dimulec/Watch-Winder/pictures/Watch_Winder_Disassembled_2.jpg

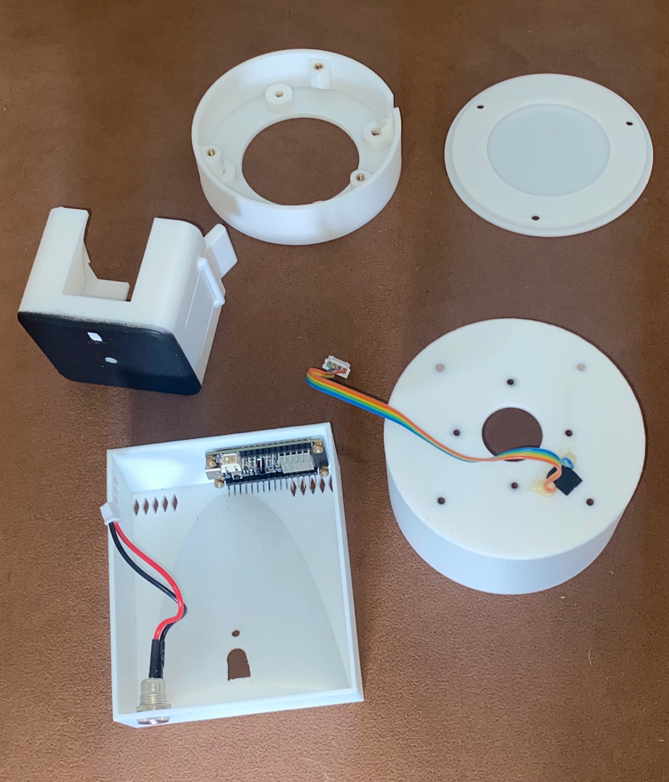
pictures/Watch_Winder_Disassembled_2.jpg
