dimulec/Watch-Winder/pictures/Watch_Winder_Disassembled_1.jpg

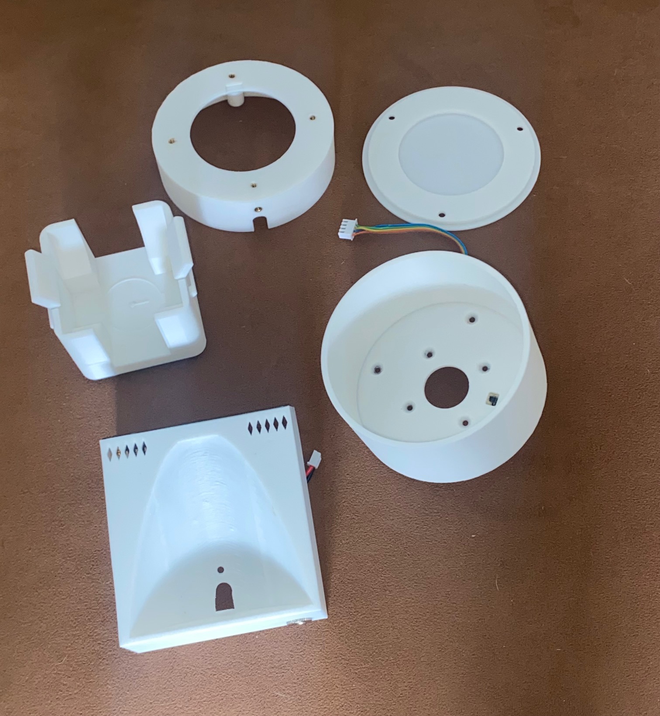
pictures/Watch_Winder_Disassembled_1.jpg
