dimulec/Watch-Winder/code/images/Both.bmp

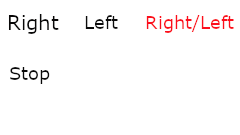
code/images/Both.bmp
