dimulec/Watch-Winder/pictures/2_Cross_Boards.jpg

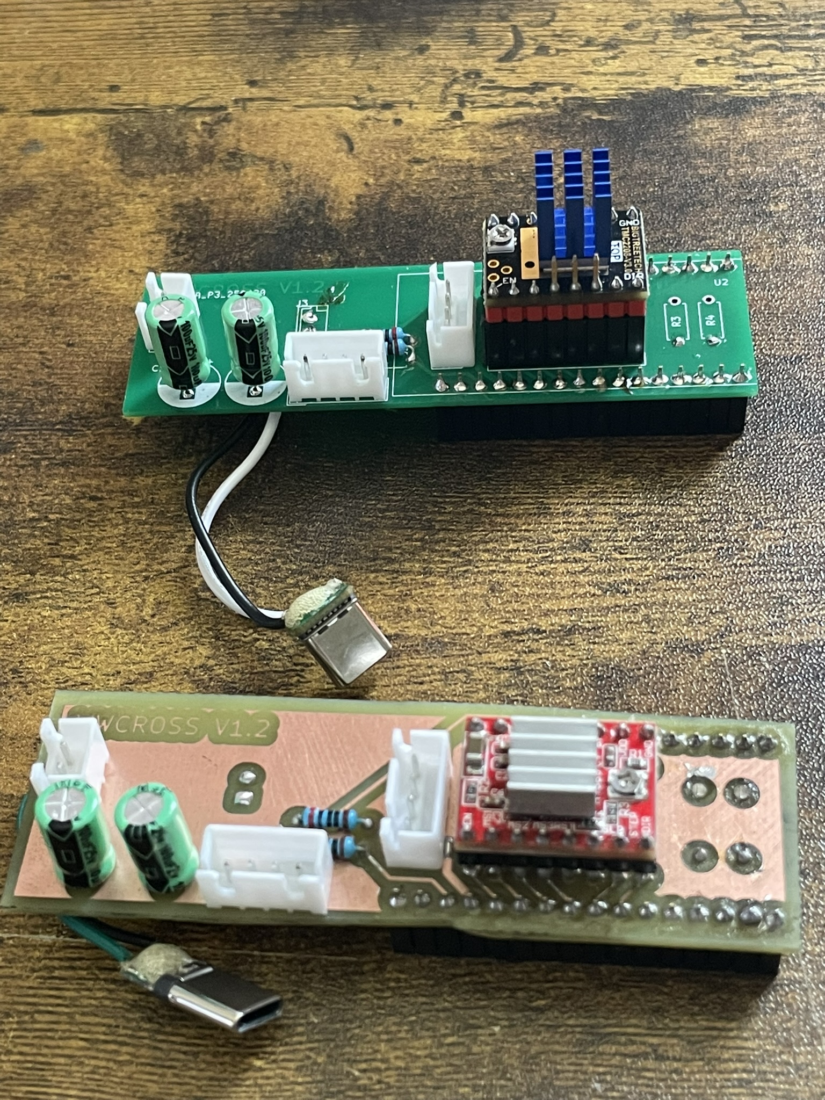
pictures/2_Cross_Boards.jpg
