dimulec/Watch-Winder/pictures/A_Bunch_of_Sensor_Boards.jpg

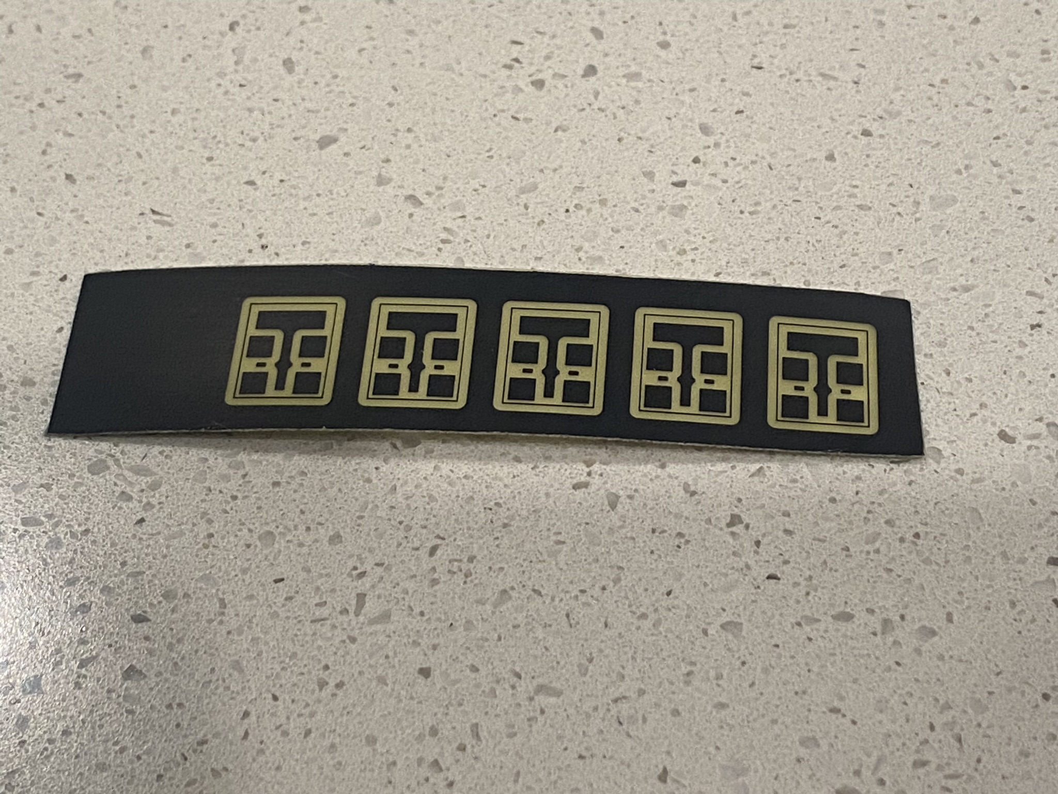
pictures/A_Bunch_of_Sensor_Boards.jpg
