dimulec/Watch-Winder/pictures/Back_View.jpg

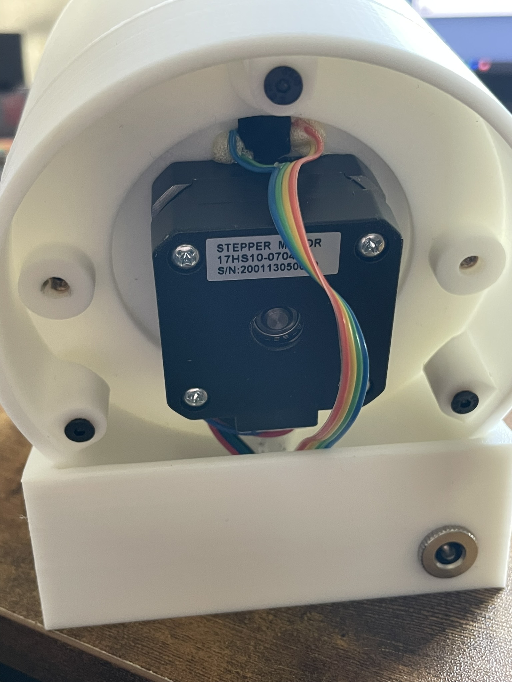
pictures/Back_View.jpg
