dimulec/Watch-Winder/pictures/Bottom_View.jpg

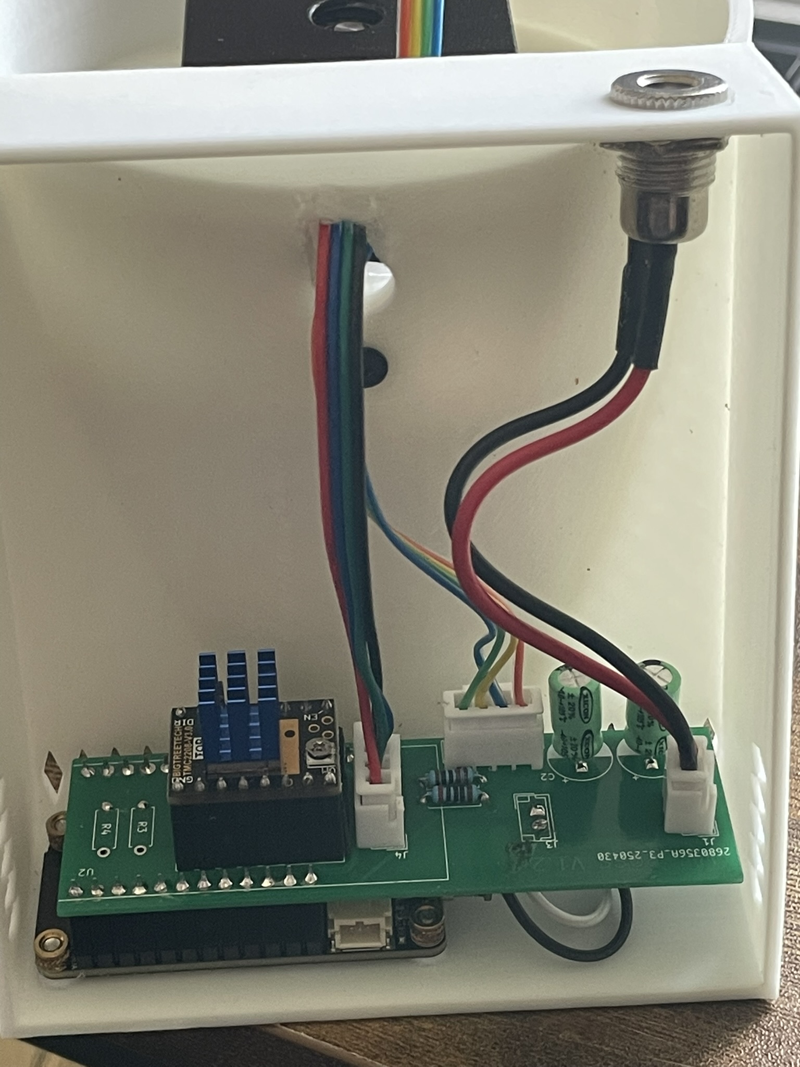
pictures/Bottom_View.jpg
