dimulec/Watch-Winder/pictures/Etching_H2O2+HCL.jpg

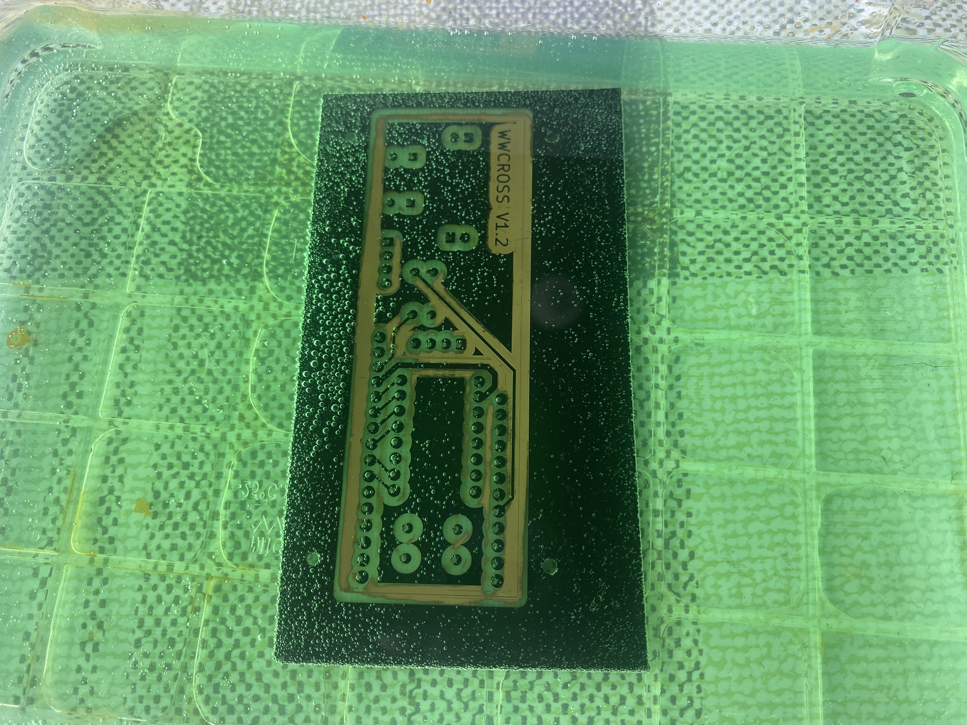
pictures/Etching_H2O2+HCL.jpg
