dimulec/Watch-Winder/pictures/Homemade_Cross_Board.jpg

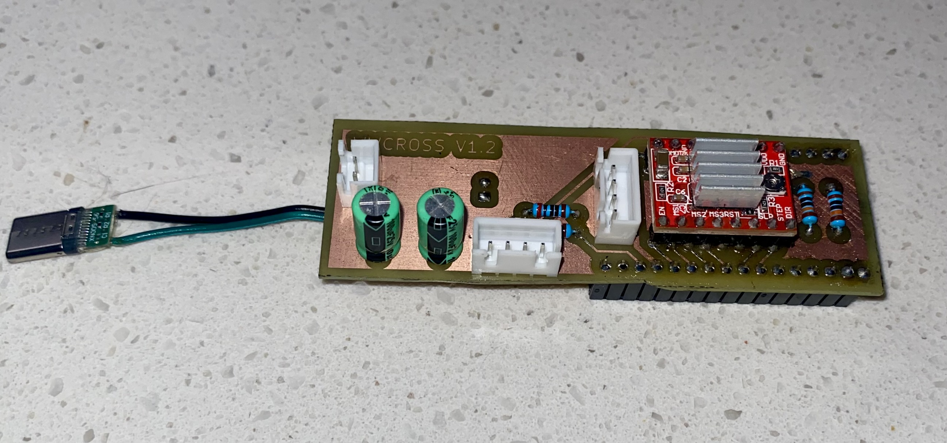
pictures/Homemade_Cross_Board.jpg
