dimulec/Watch-Winder/pictures/Homemade_Cross_Board_2.jpg

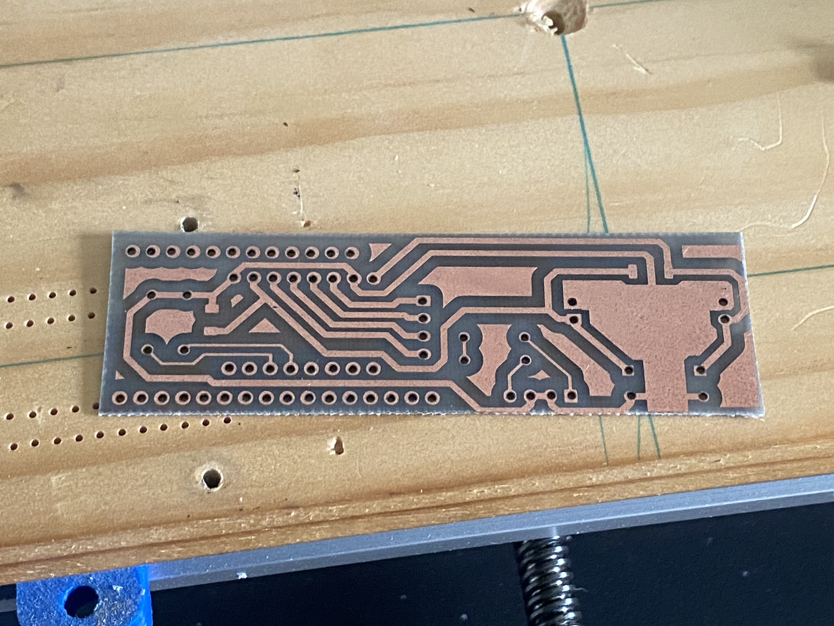
pictures/Homemade_Cross_Board_2.jpg
