dimulec/Watch-Winder/pictures/Ready_for_etching.jpg

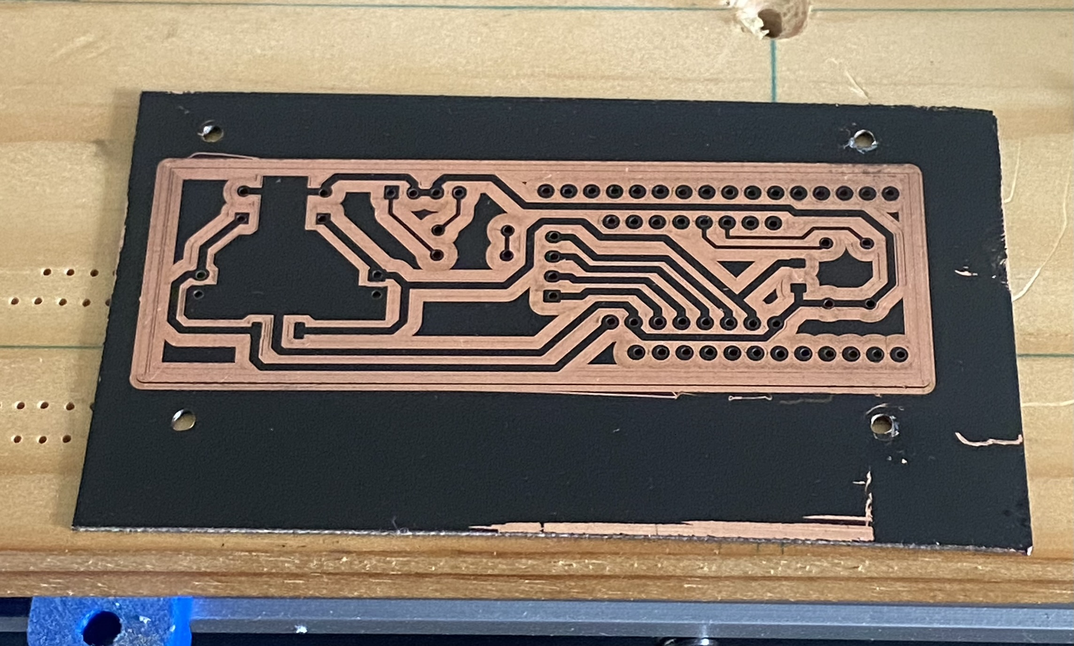
pictures/Ready_for_etching.jpg
