dimulec/Watch-Winder/pictures/Ready_for_Laser_Routing.jpg

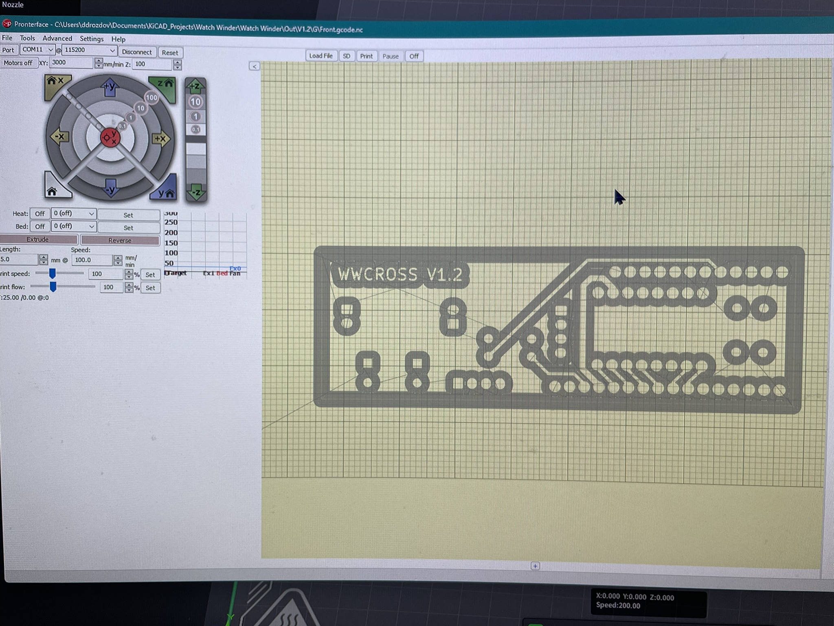
pictures/Ready_for_Laser_Routing.jpg
