dimulec/Watch-Winder/pictures/Rendering.png

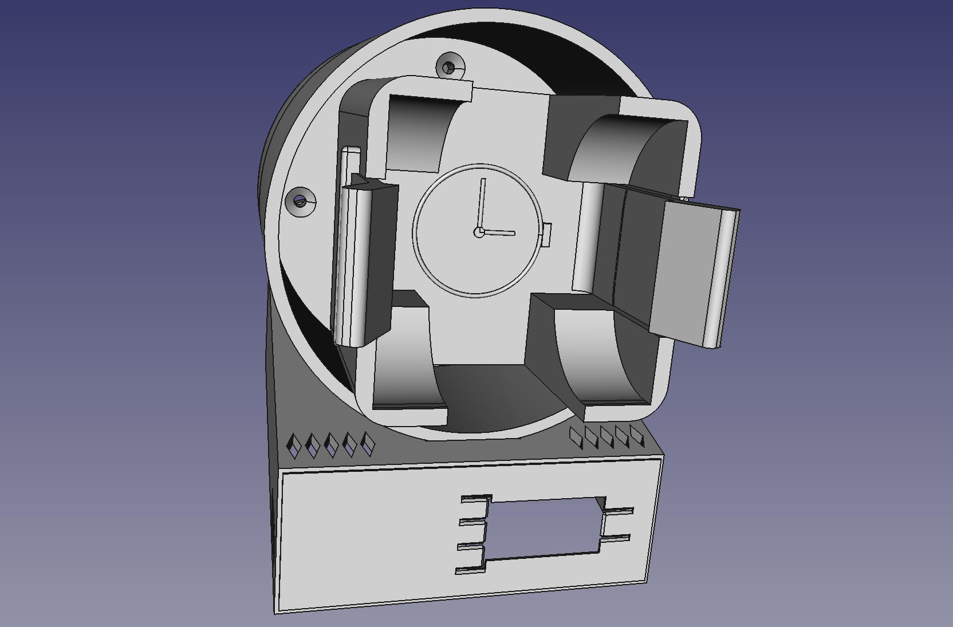
pictures/Rendering.png
