dimulec/Watch-Winder/pictures/Sensor_Layout.jpg

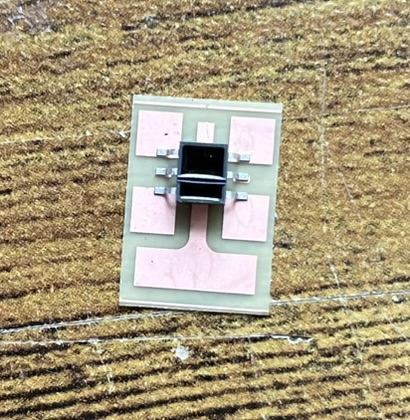
pictures/Sensor_Layout.jpg
