dimulec/Watch-Winder/pictures/Watch_Winder_PLA.jpg

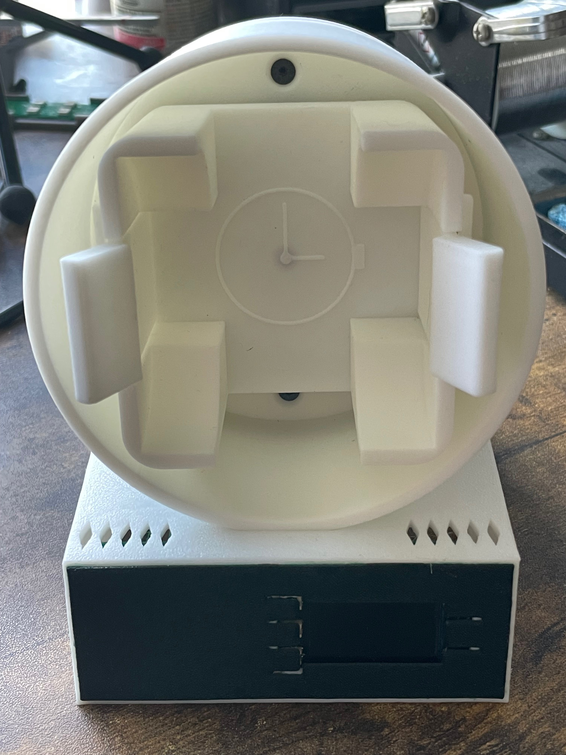
pictures/Watch_Winder_PLA.jpg
