dimulec/Watch-Winder/parts/Watch Holder 1.jpg

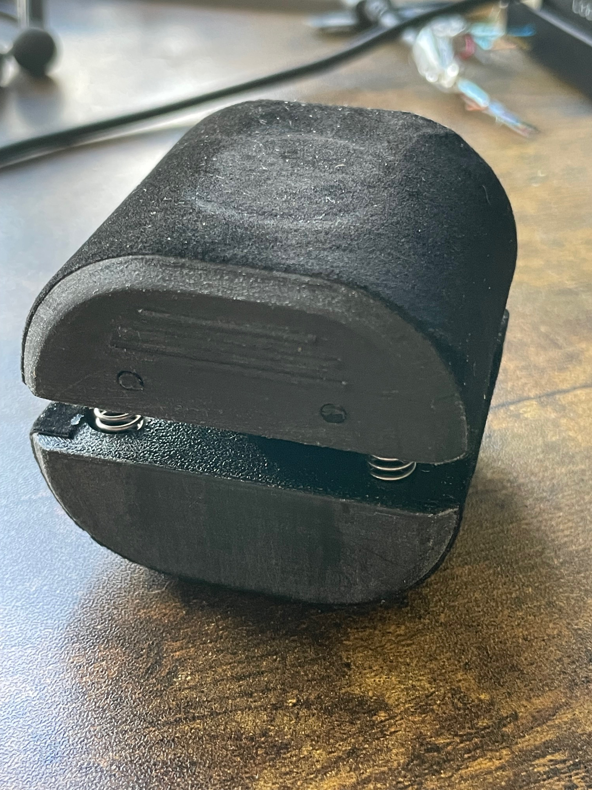
parts/Watch Holder 1.jpg
