dimulec/Watch-Winder/parts/Watch Holder 2.jpg

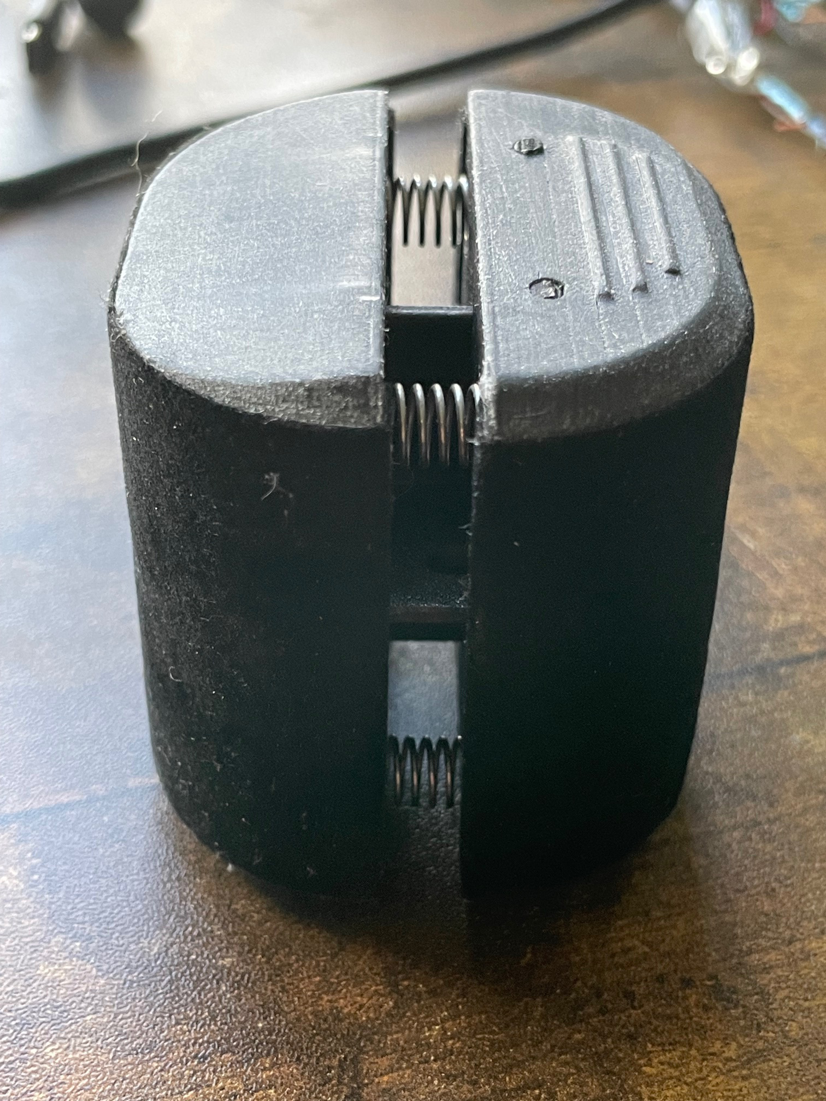
parts/Watch Holder 2.jpg
