dimulec/Watch-Winder/parts/Watch Winder-Guide 1.stl

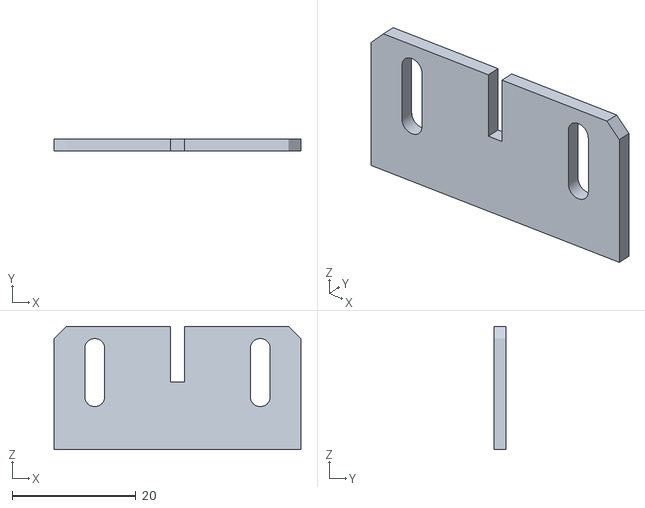
[picture p18: CAD file, 2025-05-09]
parts/Watch Winder-Guide 1.stl
40.0 x 2.00 x 20.0
