dimulec/Watch-Winder/parts/Watch Winder-Watch Holder Bottom V2.stl

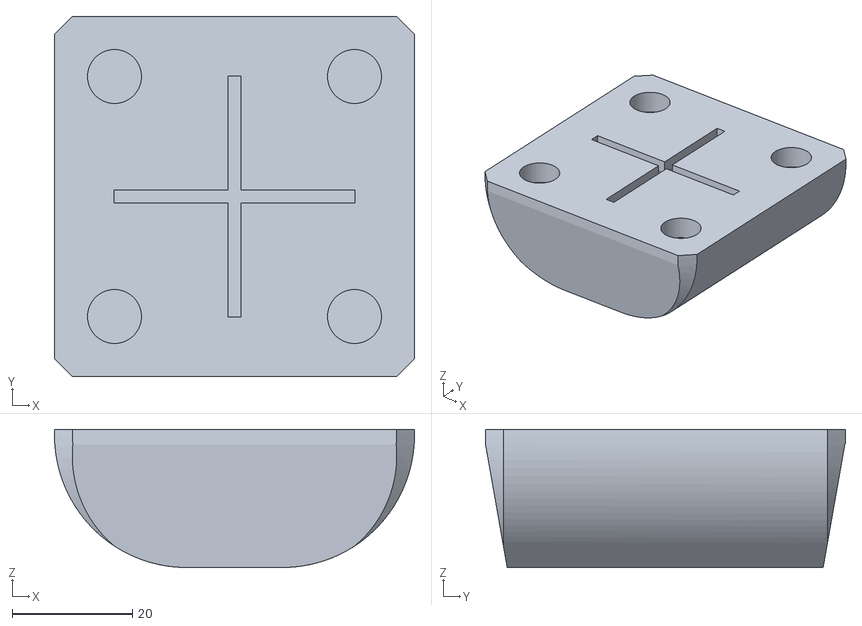
[picture p19: CAD file, 2025-05-09]
parts/Watch Winder-Watch Holder Bottom V2.stl
60.0 x 60.0 x 23.0
