dimulec/Watch-Winder/parts/Watch Winder-Watch Holder Top V2.stl

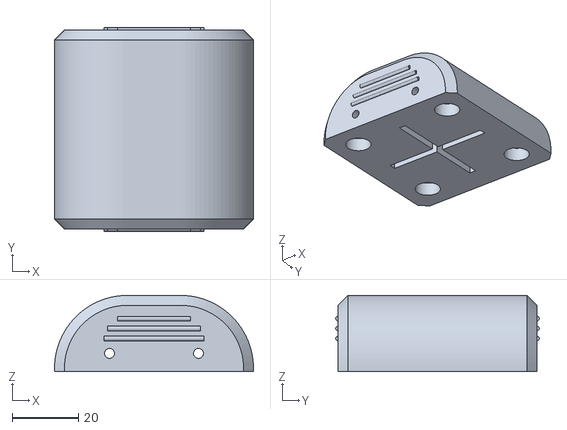
[picture p20: CAD file, 2025-05-09]
parts/Watch Winder-Watch Holder Top V2.stl
60.0 x 61.4 x 23.0
