dimulec/Watch-Winder/parts/Watch Winder-Shell 2.stl

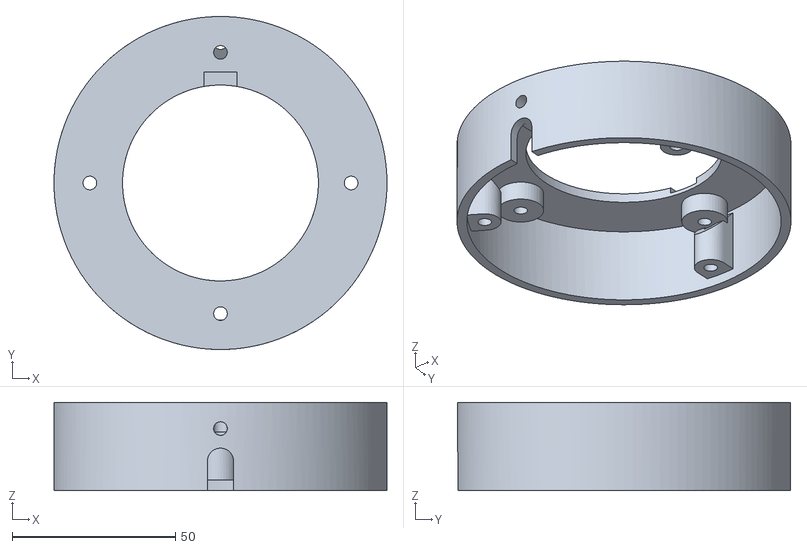
[picture p21: CAD file, 2025-05-09]
parts/Watch Winder-Shell 2.stl
102.0 x 102.0 x 27.0
