dimulec/Watch-Winder/parts/Watch Winder-Cover.stl

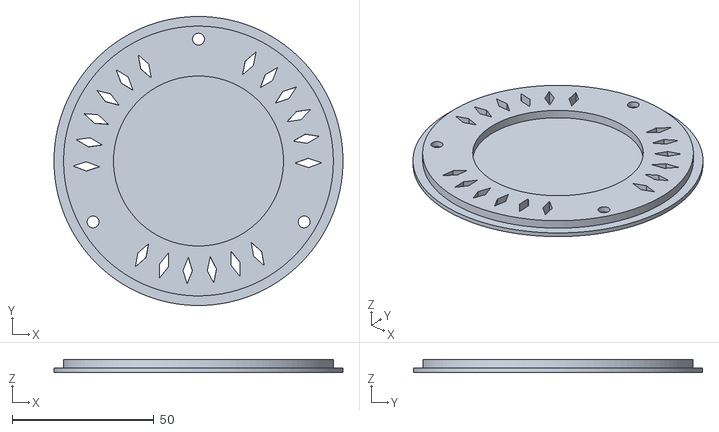
[picture p22: CAD file, 2025-05-09]
parts/Watch Winder-Cover.stl
102.0 x 102.0 x 4.50
