dimulec/Watch-Winder/parts/Watch Winder-Castle Holder.stl

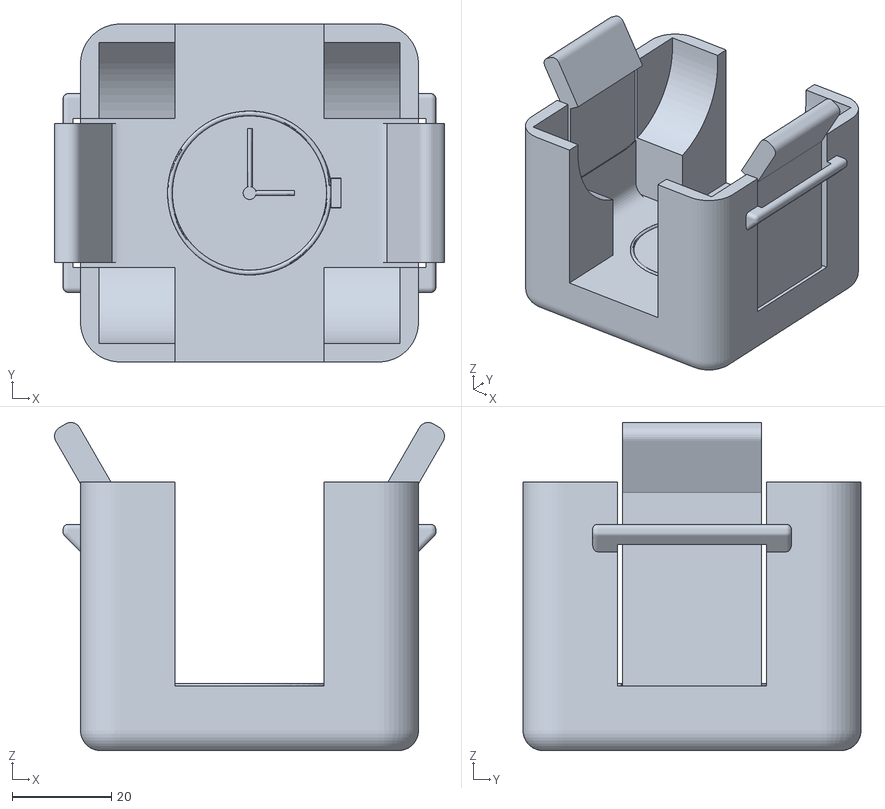
[picture p23: CAD file, 2025-05-09]
parts/Watch Winder-Castle Holder.stl
78.5 x 68.0 x 66.0
