dimulec/Watch-Winder/parts/Watch Winder-Face.stl

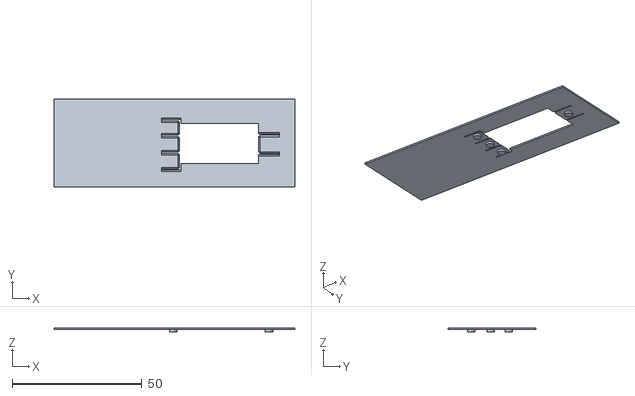
[picture p24: CAD file, 2025-05-09]
parts/Watch Winder-Face.stl
93.0 x 34.0 x 1.40
