dimulec/Watch-Winder/parts/Watch Winder-Base.stl

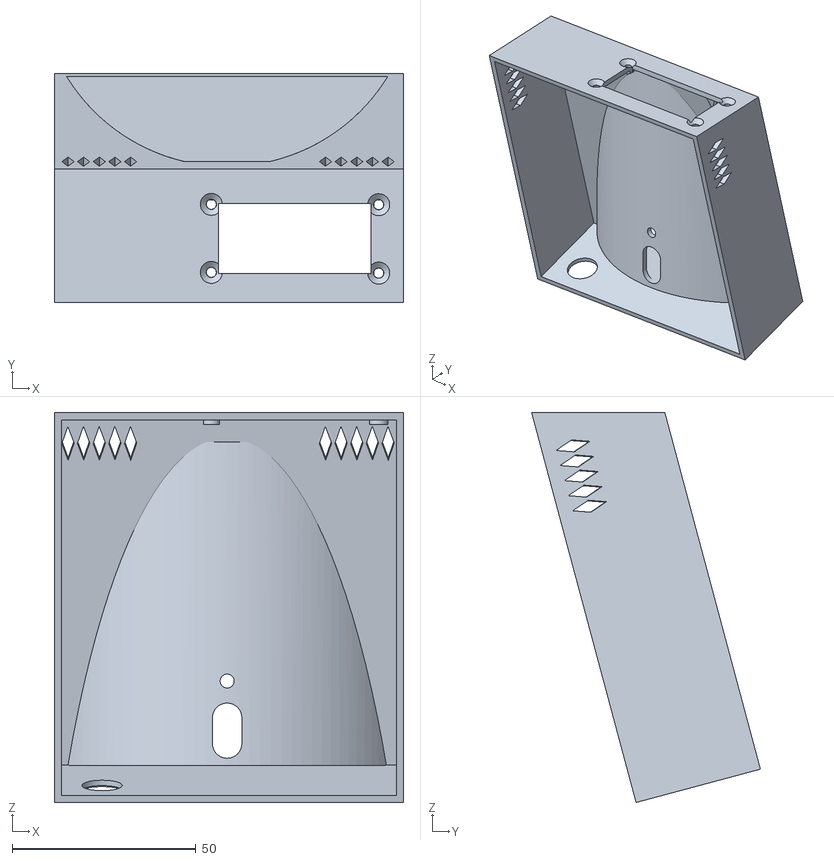
[picture p25: CAD file, 2025-05-09]
parts/Watch Winder-Base.stl
95.0 x 62.2 x 106.0
