dimulec/Watch-Winder/parts/Watch Winder-Shell 1.stl

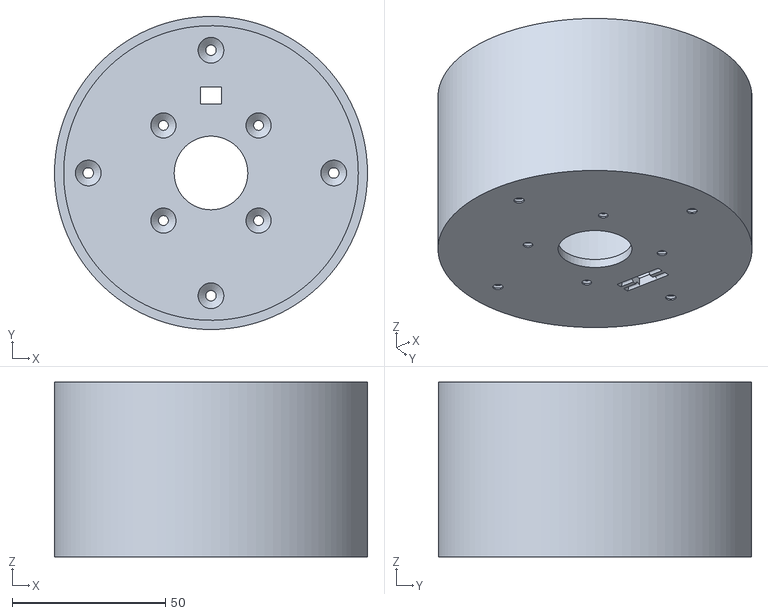
[picture p26: CAD file, 2025-05-09]
parts/Watch Winder-Shell 1.stl
102.0 x 102.0 x 57.0
