dimulec/Watch-Winder/(list of files, cad)

Other CAD files:
parts/Watch Winder-Guide 2.stl
