dimulec/Watch-Winder/(commit log)

2025-05-09 Watch Winder for mechanical watch
    Temp
    [WWCROSS-B_Cu.gbr, WWCROSS-B_Mask.gbr, WWCROSS-B_Paste.gbr, WWCROSS-B_Silkscreen.gbr, WWCROSS-Edge_Cuts.gbr, WWCROSS-F_Cu.gbr, WWCROSS-F_Mask.gbr, WWCROSS-F_Paste.gbr]
2025-05-09 Additional parts
    [Watch Winder-Guide 1.stl, Watch Winder-Guide 2.stl, Watch Winder-Watch Holder Bottom V2.stl, Watch Winder-Watch Holder Top V2.stl]
2025-05-11 PCB corrections
    [WWCROSS-B_Cu.gbr, Watch Winder-B_Cu.gbr, Watch Winder-B_Mask.gbr, Watch Winder-B_Paste.gbr, Watch Winder-B_Silkscreen.gbr, Watch Winder-Edge_Cuts.gbr, Watch Winder-F_Cu.gbr, Watch Winder-F_Mask.gbr]
